Bonchart/LineFollower/Schematy/STM LQFP32/płytka główna/plytka_glowna.brd

## EAGLE design Schematy/STM LQFP32/płytka główna/plytka_glowna.brd (2016-11-22)

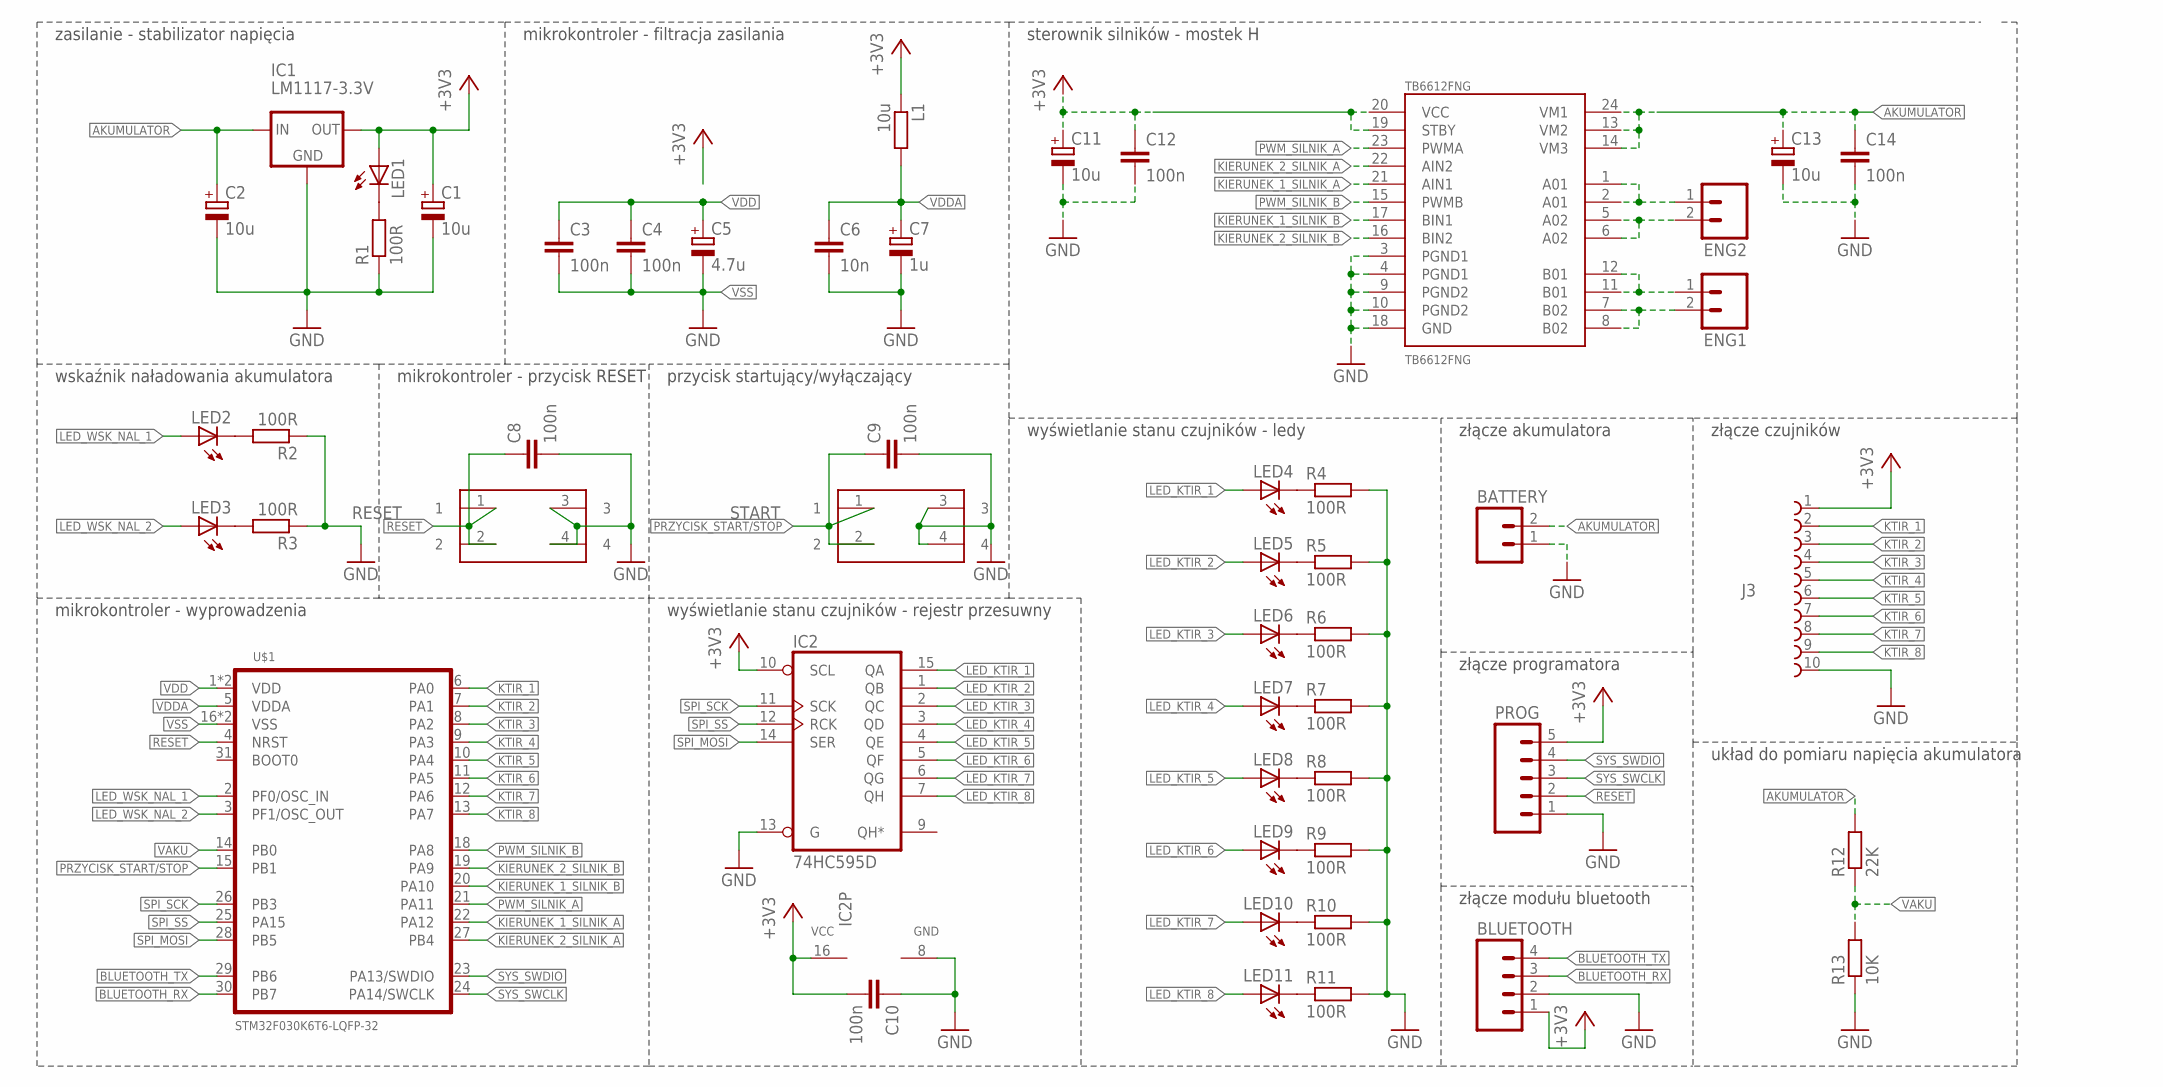
[picture p1: schematic plytka_glowna.sch]

Parts:
BATTERY: M02-JST-2-PTH-NO_SILK; JST-2-PTH-NS
BLUETOOTH: M04JST; 1X04-1.5MM_JST
C1, C2, C11, C13: 10u; UD-4X5,8_NICHICON
C3, C4, C8, C9, C10, C12, C14: 100n; C0805
C5: 4.7u; SMC_A
C6: 10n; C0805
C7: 1u; SMC_A
ENG1, ENG2: M02-JST-2-PTH-NO_SILK; JST-2-PTH-NS
IC1: LM1117-3.3V; TO252
IC2: 74HC595D; SO16
J3: 68611014422
L1: 10u; R0805
LED1, LED2, LED3, LED4, LED5, LED6, LED7, LED8, LED9, LED10, LED11: LEDCHIP-LED0805; CHIP-LED0805
PROG: M05LOCK_LONGPADS; 1X05_LOCK_LONGPADS
R1, R2, R3, R4, R5, R6, R7, R8, R9, R10, R11: 100R; M0805
R12: 22K; M0805
R13: 10K; M0805
RESET: 430186043916
START: 430186043916
TB6612FNG: TB6612FNG; SSOP24
U$1: STM32F030K6T6-LQFP-32; LQFP-32

Connections:
+3V3: BLUETOOTH.1, C1.+, C10.2, IC1.TAB (OUT), IC2.10 (SCL), IC2.16 (VCC), J3.1, L1.1, LED1.A, PROG.5
AKUMULATOR: BATTERY.2, C2.+, C13.+, C14.1, IC1.2 (IN), R12.2, TB6612FNG.13 (VM2), TB6612FNG.14 (VM3), TB6612FNG.24 (VM1)
BLUETOOTH_RX: BLUETOOTH.3, U$1.30 (PB7)
BLUETOOTH_TX: BLUETOOTH.4, U$1.29 (PB6)
GND: BATTERY.1, BLUETOOTH.2, C1.-, C2.-, C6.2, C7.-, C8.2, C9.2, C10.1, C11.-, C12.2, C13.-, C14.2, IC1.1 (GND), IC2.8 (GND), IC2.13 (G), J3.10, PROG.1, R1.1, R2.1, R3.1, R4.2, R5.2, R6.2, R7.2, R8.2, R9.2, R10.2, R11.2, R13.1, RESET.3, RESET.4, START.3, START.4, TB6612FNG.3 (PGND1), TB6612FNG.4 (PGND1), TB6612FNG.9 (PGND2), TB6612FNG.10 (PGND2), TB6612FNG.18 (GND)
KIERUNEK_1_SILNIK_A: TB6612FNG.21 (AIN1), U$1.22 (PA12)
KIERUNEK_1_SILNIK_B: TB6612FNG.17 (BIN1), U$1.20 (PA10)
KIERUNEK_2_SILNIK_A: TB6612FNG.22 (AIN2), U$1.27 (PB4)
KIERUNEK_2_SILNIK_B: TB6612FNG.16 (BIN2), U$1.19 (PA9)
KTIR_1: J3.2, U$1.6 (PA0)
KTIR_2: J3.3, U$1.7 (PA1)
KTIR_3: J3.4, U$1.8 (PA2)
KTIR_4: J3.5, U$1.9 (PA3)
KTIR_5: J3.6, U$1.10 (PA4)
KTIR_6: J3.7, U$1.11 (PA5)
KTIR_7: J3.8, U$1.12 (PA6)
KTIR_8: J3.9, U$1.13 (PA7)
LED_KTIR_1: IC2.15 (QA), LED4.A
LED_KTIR_2: IC2.1 (QB), LED5.A
LED_KTIR_3: IC2.2 (QC), LED6.A
LED_KTIR_4: IC2.3 (QD), LED7.A
LED_KTIR_5: IC2.4 (QE), LED8.A
LED_KTIR_6: IC2.5 (QF), LED9.A
LED_KTIR_7: IC2.6 (QG), LED10.A
LED_KTIR_8: IC2.7 (QH), LED11.A
LED_WSK_NAL_1: LED2.A, U$1.2 (PF0/OSC_IN)
LED_WSK_NAL_2: LED3.A, U$1.3 (PF1/OSC_OUT)
unnamed: LED1.C, R1.2
unnamed: LED2.C, R2.2
unnamed: LED3.C, R3.2
unnamed: LED4.C, R4.1
unnamed: LED5.C, R5.1
unnamed: ENG2.2, TB6612FNG.5 (A02), TB6612FNG.6 (A02)
unnamed: ENG1.2, TB6612FNG.7 (B02), TB6612FNG.8 (B02)
unnamed: LED6.C, R6.1
unnamed: ENG1.1, TB6612FNG.11 (B01), TB6612FNG.12 (B01)
unnamed: LED7.C, R7.1
unnamed: ENG2.1, TB6612FNG.1 (A01), TB6612FNG.2 (A01)
unnamed: LED8.C, R8.1
unnamed: LED9.C, R9.1
unnamed: LED10.C, R10.1
unnamed: LED11.C, R11.1
PRZYCISK_START/STOP: C9.1, START.1, START.2, U$1.15 (PB1)
PWM_SILNIK_A: TB6612FNG.23 (PWMA), U$1.21 (PA11)
PWM_SILNIK_B: TB6612FNG.15 (PWMB), U$1.18 (PA8)
RESET: C8.1, PROG.2, RESET.1, RESET.2, U$1.4 (NRST)
SPI_MOSI: IC2.14 (SER), U$1.28 (PB5)
SPI_SCK: IC2.11 (SCK), U$1.26 (PB3)
SPI_SS: IC2.12 (RCK), U$1.25 (PA15)
SYS_SWCLK: PROG.3, U$1.24 (PA14/SWCLK)
SYS_SWDIO: PROG.4, U$1.23 (PA13/SWDIO)
TB6612_VCC: C11.+, C12.1, TB6612FNG.19 (STBY), TB6612FNG.20 (VCC)
VAKU: R12.1, R13.2, U$1.14 (PB0)
VDD: C3.1, C4.1, C5.+, U$1.1 (VDD), U$1.17 (VDD)
VDDA: C6.1, C7.+, L1.2, U$1.5 (VDDA)
VSS: C3.2, C4.2, C5.-, U$1.16 (VSS), U$1.32 (VSS)

Notes on the sheet:
mikrokontroler - wyprowadzenia
wskaźnik naładowania akumulatora
mikrokontroler - przycisk RESET
mikrokontroler - filtracja zasilania
zasilanie - stabilizator napięcia
przycisk startujący/wyłączający
wyświetlanie stanu czujników - rejestr przesuwny
wyświetlanie stanu czujników - ledy
złącze modułu bluetooth
złącze programatora
układ do pomiaru napięcia akumulatora
złącze czujników
sterownik silników - mostek H
złącze akumulatora

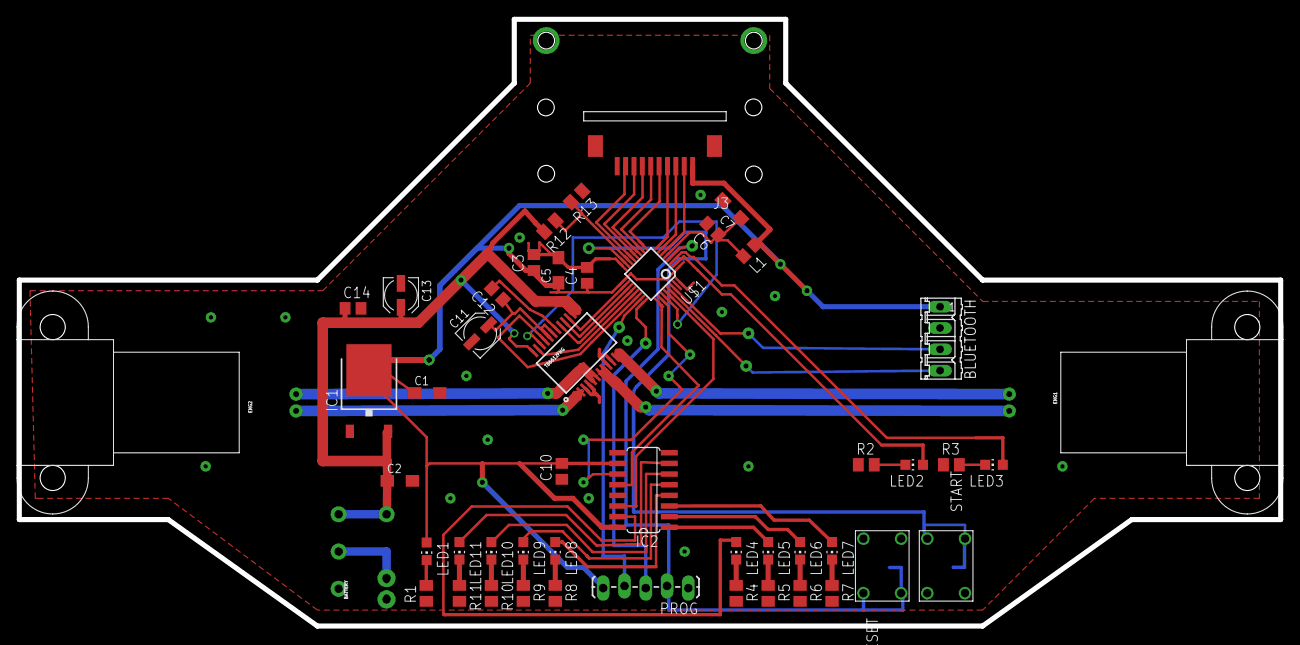
[picture p2: board plytka_glowna.brd from above]

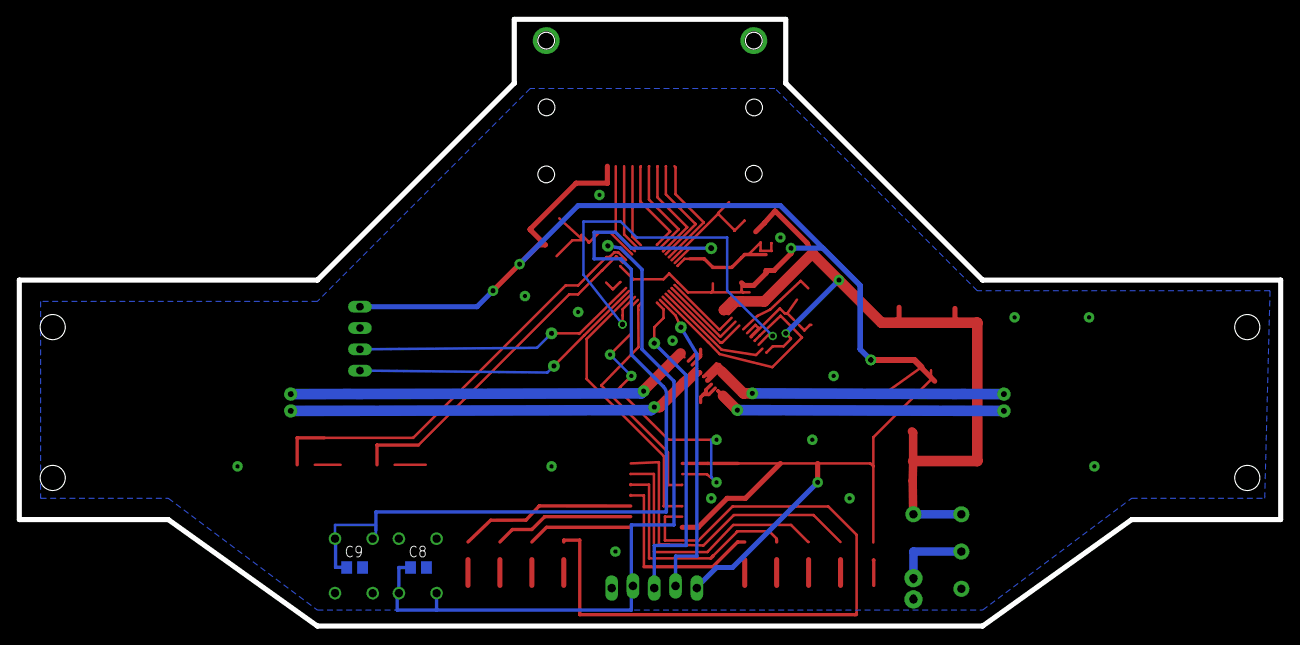
[picture p3: board plytka_glowna.brd from below]

Board: 2 copper layers, 150.5 x 72.4 mm, 53 parts (2 on the bottom side), 56 nets.

Other parts of the board:
U$3, U$4: HP_NM
