Bonchart/LineFollower/Schematy/STM LQFP32/listwa z czujnikami/listwa_z_czujnikami.brd

## EAGLE design Schematy/STM LQFP32/listwa z czujnikami/listwa_z_czujnikami.brd (2016-11-22)

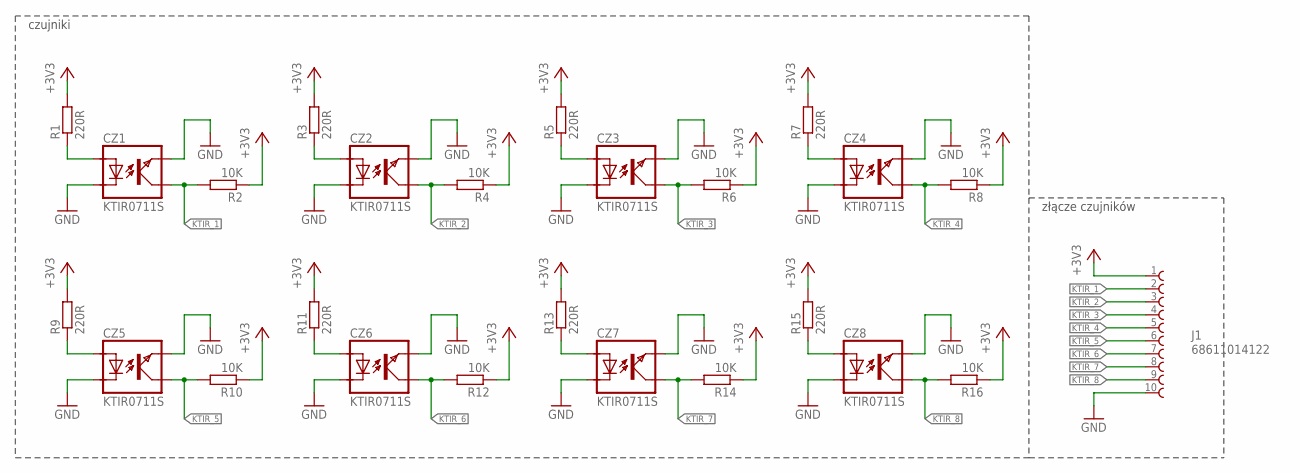
[picture p4: schematic listwa_z_czujnikami.sch]

Parts:
CZ1, CZ2, CZ3, CZ4, CZ5, CZ6, CZ7, CZ8: KTIR0711S; TOP
J1: 68611014122
R1, R3, R5, R7, R9, R11, R13, R15: 220R; R0805
R2, R4, R6, R8, R10, R12, R14, R16: 10K; R0805

Connections:
+3V3: J1.1, R1.2, R2.1, R3.2, R4.1, R5.2, R6.1, R7.2, R8.1, R9.2, R10.1, R11.2, R12.1, R13.2, R14.1, R15.2, R16.1
GND: CZ1.EMITER, CZ1.KATODA, CZ2.EMITER, CZ2.KATODA, CZ3.EMITER, CZ3.KATODA, CZ4.EMITER, CZ4.KATODA, CZ5.EMITER, CZ5.KATODA, CZ6.EMITER, CZ6.KATODA, CZ7.EMITER, CZ7.KATODA, CZ8.EMITER, CZ8.KATODA, J1.10
KTIR_1: CZ1.KOLEKTOR, J1.2, R2.2
KTIR_2: CZ2.KOLEKTOR, J1.3, R4.2
KTIR_3: CZ3.KOLEKTOR, J1.4, R6.2
KTIR_4: CZ4.KOLEKTOR, J1.5, R8.2
KTIR_5: CZ5.KOLEKTOR, J1.6, R10.2
KTIR_6: CZ6.KOLEKTOR, J1.7, R12.2
KTIR_7: CZ7.KOLEKTOR, J1.8, R14.2
KTIR_8: CZ8.KOLEKTOR, J1.9, R16.2
unnamed: CZ2.ANODA, R3.1
unnamed: CZ1.ANODA, R1.1
unnamed: CZ3.ANODA, R5.1
unnamed: CZ4.ANODA, R7.1
unnamed: CZ5.ANODA, R9.1
unnamed: CZ6.ANODA, R11.1
unnamed: CZ7.ANODA, R13.1
unnamed: CZ8.ANODA, R15.1

Notes on the sheet:
czujniki
złącze czujników

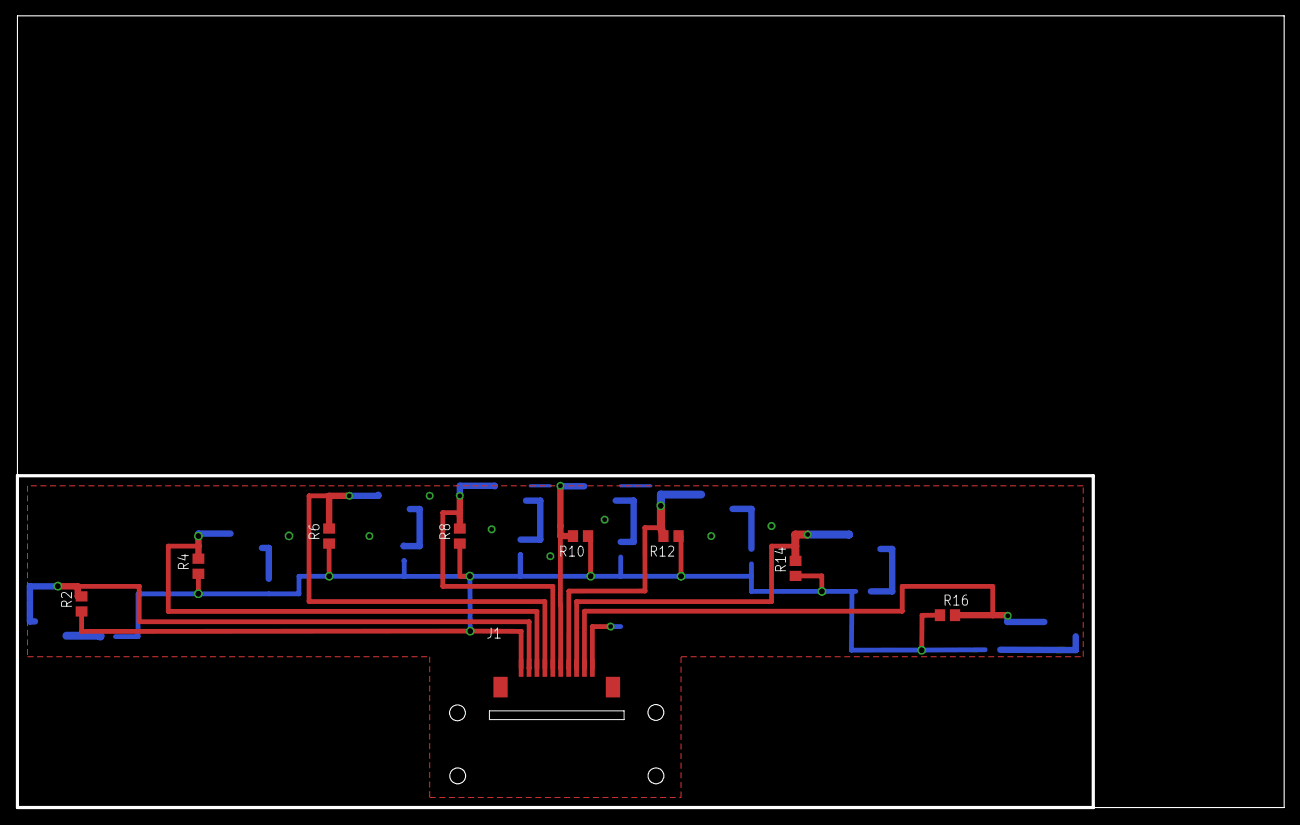
[picture p5: board listwa_z_czujnikami.brd from above]

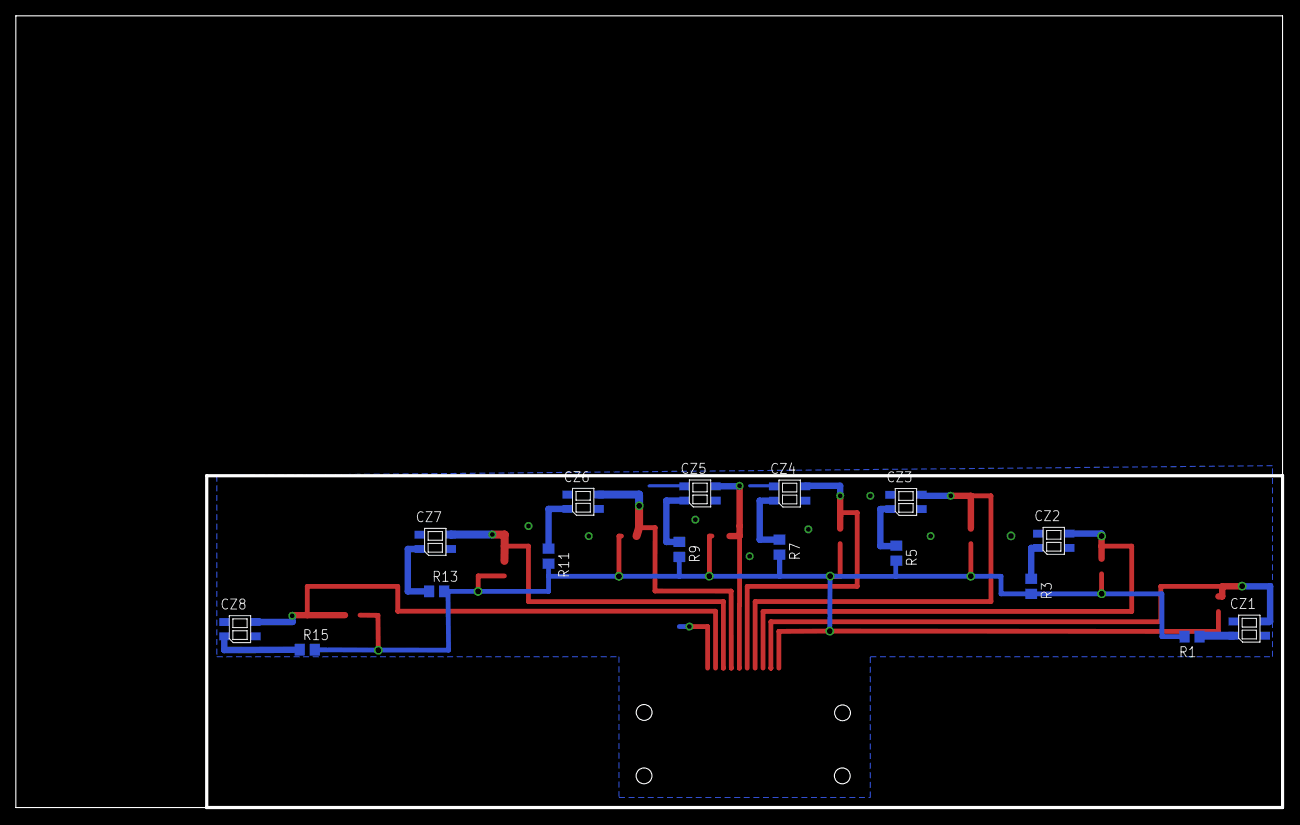
[picture p6: board listwa_z_czujnikami.brd from below]

Board: 2 copper layers, 160.0 x 100.0 mm, 25 parts (16 on the bottom side), 18 nets.
