Bonchart/LineFollower/(threads)

Thread 2 (2016-11-01):

czujniki

bialasPWr, 2016-11-01:
- [x] ilość

- 8

- [ ] ułożenie

- [x] pobór prądu

- przy napięciu 3.3 V i rezystorze 220 Ohm prąd jednej diody to 15 mA

- 8 diod daje 120 mA

- [x] podłączenie

- z noty

- [ ] połączenie z główną płytką

- taśma?

- jakie złącza?

Closed 2016-11-04.

Thread 3 (2016-11-01):

diody i przyciski do komunikacji

bialasPWr, 2016-11-01:
- [ ] dwa ledy do debugowania

- [ ] przycisk RESET

- [ ] przycisk do zaprogramowania

- [ ] 3 diody wskazujące poziom naładowania baterii/ jedna migająca

- [ ] diody sygnalizujące stan czujników odbiciowych

Closed 2016-11-04.

Thread 4 (2016-11-01):

mikrokontroler

bialasPWr, 2016-11-01:
- 8 kanałów ADC dla czujników

- 2 kanały PWM dla silników

- 4 piny I/O do sterowania silnikami

- [ ] wyprowadzenie do programowania

- [ ] proponuję STM32F100C8T6B - LQFP48

Closed 2016-11-02.

Thread 10 (2016-11-10):

elektronika

bialasPWr, 2016-11-10:
- zasilanie

   - [x] przełącznik

   - [x] regulator napięcia [LM1117-3.3V]

   - [ ] złącze akumulatora

- mikrokontroler

   - [ ] przycisk reset

   - [ ] złącze programatora

- sterownik silników

   - [x] prąd na kanał [1 A]

   - [x] ilość kanałów [2]

- czujniki

   - [x] ilość [8]

   - [ ] złącze

   - [x] prąd diod [8 x 9,5 mA]

- elementy rlc

   - [ ] rezystory

   - [ ] kondensatory

   - [ ] cewki

- [ ] przycisk start/stop

- bluetooth

   - [ ] typ [HC-06]

   - [ ] złącze

   - [ ] miejsce na płytce

- wskaźnik naładowania akumulatora

   - [x] diody [2 sztuki, czerwona i żółta]

   - [ ] układ pomiarowy

- diody odwzorowujące stany czujników

   - [x] rejestr przesuwny [74HC595]

   - [ ] diody [8, kolor?]

Closed 2016-11-23.

Thread 11 (2016-11-11):

program

bialasPWr, 2016-11-11:
- [ ] obsługa przycisku start/stop

- [ ] odczyt z czujników (ADC)

- [ ] pomiar naładowania akumulatora (ADC)

- [ ] regulator PD

- [ ] sterowanie silnikami (PWM + kierunkowe)

- [ ] sterowanie diodami odwzorowującymi stan czujników (SPI)

- [ ] bluetooth (UART)

Closed 2016-11-23.
