Bonchart/LineFollower/(commit log)

2016-11-01 Delete K
    robię porządek
2016-11-02 czy doda folder?
    [schemat.kicad_pcb, schemat.sch]
2016-11-02 Schematy [folder właściwy]
    Niech to będzie folder ze schematami. Kolejne zmiany będę dodawał przez nową gałąź.
    [listwa_z_czujnikami.kicad_pcb, listwa_z_czujnikami.sch]
2016-11-02 Rozpoczęty schemat płyty głównej [mostek H]
    [plyta_glowna.kicad_pcb, plyta_glowna.sch]
2016-11-02 Płyta główna + listwa - do sprawdzenia
    do zrobienia układ pomiarowy obniżający napięcie z akumulatora do tolerowanego przez uC, dobranie złącz
    [listwa_z_czujnikami.kicad_pcb, listwa_z_czujnikami.sch, plyta_glowna.kicad_pcb, plyta_glowna.sch]
2016-11-02 Płyta główna + listwa [do sprawdzenia]
    do zrobienia:
    - układ pomiarowy napięcia na akumulatorze
    - wskaźnik naładowania akumulatora na 3 led
    - dobrać złącza
    - zagospodarować pozostałe piny
    [plyta_glowna.sch]
2016-11-03 Kompletny schemat elektryczny [do sprawdzenia]
    [listwa_z_czujnikami.sch, plyta_glowna.sch]
2016-11-04 Schemat elektryczny
    @edit
    zmiana modułu bluetooth z HC-05 na HC-06
    [listwa_z_czujnikami.sch, plyta_glowna.sch]
2016-11-05 Dorzucam schemat w Eagledla STM32 w obudowie LQFP32
    [listwa_z_czujnikami.kicad_pcb, listwa_z_czujnikami.sch, plyta_glowna.kicad_pcb, plyta_glowna.sch, plytka_glowna.sch]
2016-11-06 Lista elementów
    [Lista elementów.xlsx]
2016-11-06 Płytka główna + listwa z czujnikami
    * dodałem listwę z czujnikami
    * poprawiłem cewkę przy mikrokontrolerze
    * zmieniłem złącze czujników na 1x10
    * poprawiłem złącze do modułu bluetooth
    [listwa_z_czujnikami.sch, plytka_glowna.sch]
2016-11-07 Złącze FFC
    [plytka_glowna.sch]
2016-11-07 Add files via upload
    Listwa FFC
    [plytka_glowna.sch]
2016-11-17 Płytka gotowa
    [Lista elementów.xlsx, plytka_glowna.brd, plytka_glowna.sch]
2016-11-17 poprawiona płytka główna
    [plytka_glowna.brd]
2016-11-19 Listwa koniec
    [listwa_z_czujnikami.brd, listwa_z_czujnikami.sch, plytka_glowna.brd]
2016-11-22 Poprawione PCB
    [listwa_z_czujnikami.brd, plytka_glowna.brd]
2016-11-23 Posprzątane
    [listwa_z_czujnikami.sch, plytka_glowna.brd, plytka_glowna.sch]
