Bonchart/LineFollower/(notices)

Notices in the files:
parts and their libraries:
FPC_Connectors_Flat_Flexible_Cable_rev15: Copyright: Würth Elektronik
SparkFun-Connectors: Licensing: Creative Commons ShareAlike 4.0 International - https://creativecommons.org/licenses/by-sa/4.0
